31337H4X0R/crab-tracker/hardware/Gerber fab files/README.md

These zipped folders contain all files necessary to fabricate printed circuit boards (PCBs) used for the Crab Tracker. Most fabricators will accept these zipped files without modifications. See `/hardware/Appendix2.pdf` for lists of components needed to populate each PCB

See `/hardware/Design Files` to download fully edittable design files. Design and fabrication files were generated with Altium Designer.
