31337H4X0R/crab-tracker/doc/Collisions/graphics/collision1.png

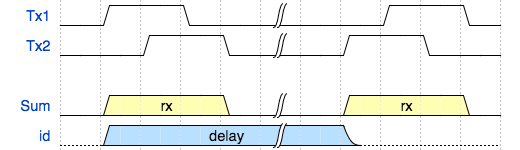
doc/Collisions/graphics/collision1.png
