31337H4X0R/crab-tracker/(commit log)

2019-07-31 Rename hardware/Gerber fab files/README.md to hardware/Gerber_Fab_Files/README.md
2019-07-31 Rename hardware/Gerber_Fab_Files/README.md to hardware/Gerber fab files/README.md
